rhit-olsonkc1/AdaCore-Protoboard/board/Board-Schematic.pdf

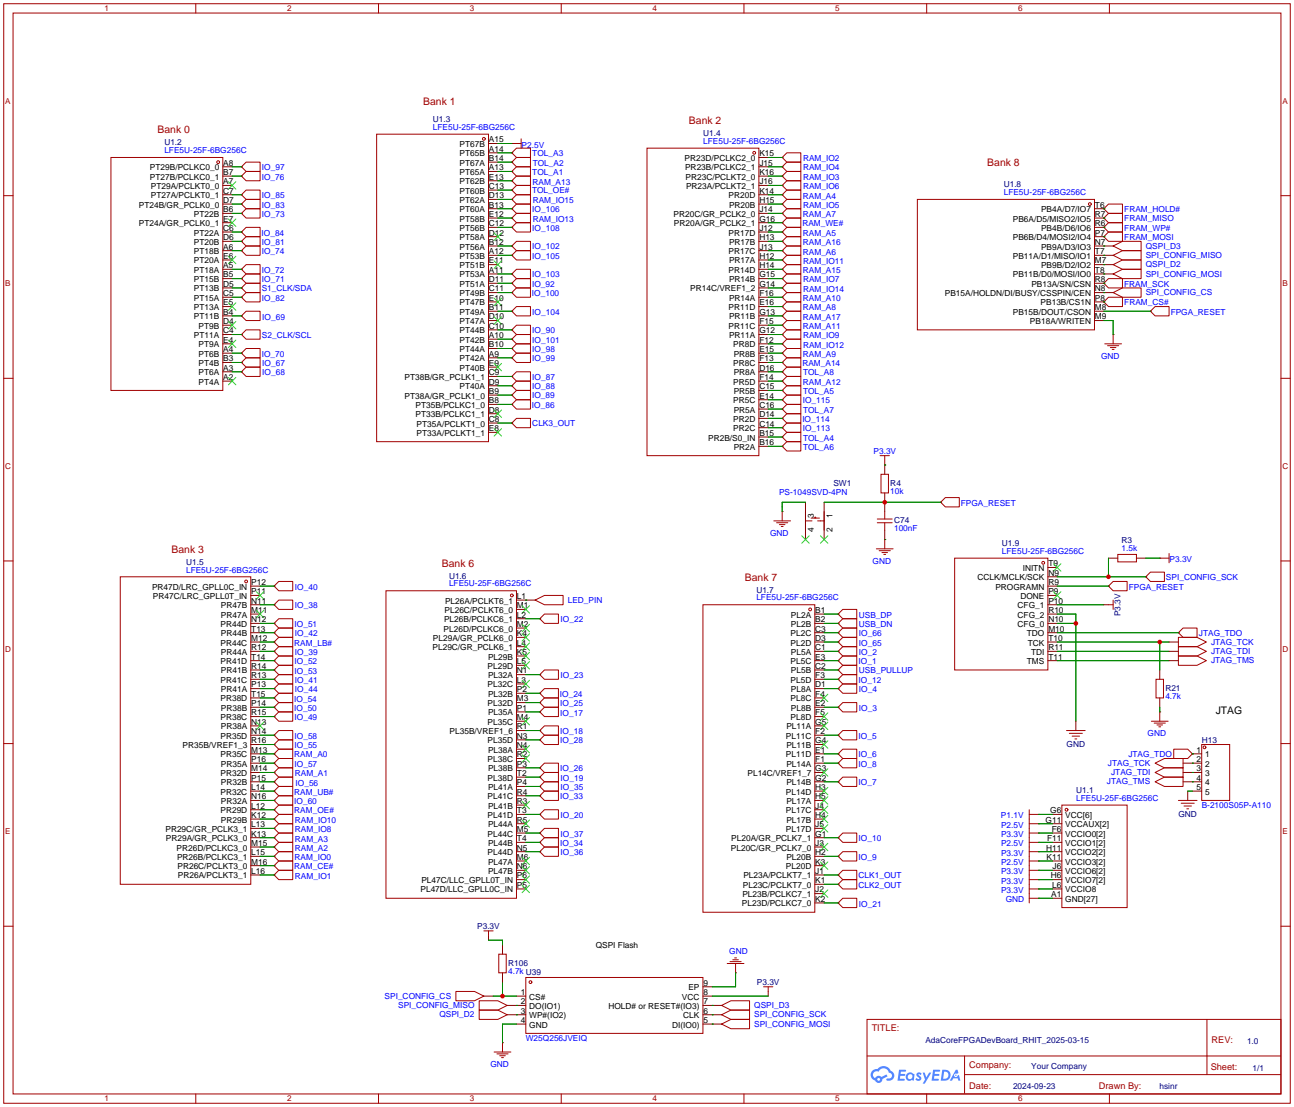
[picture p9: page 1]

PB15A/HOLDN/DI/BUSY/CSSPIN/CEN N8

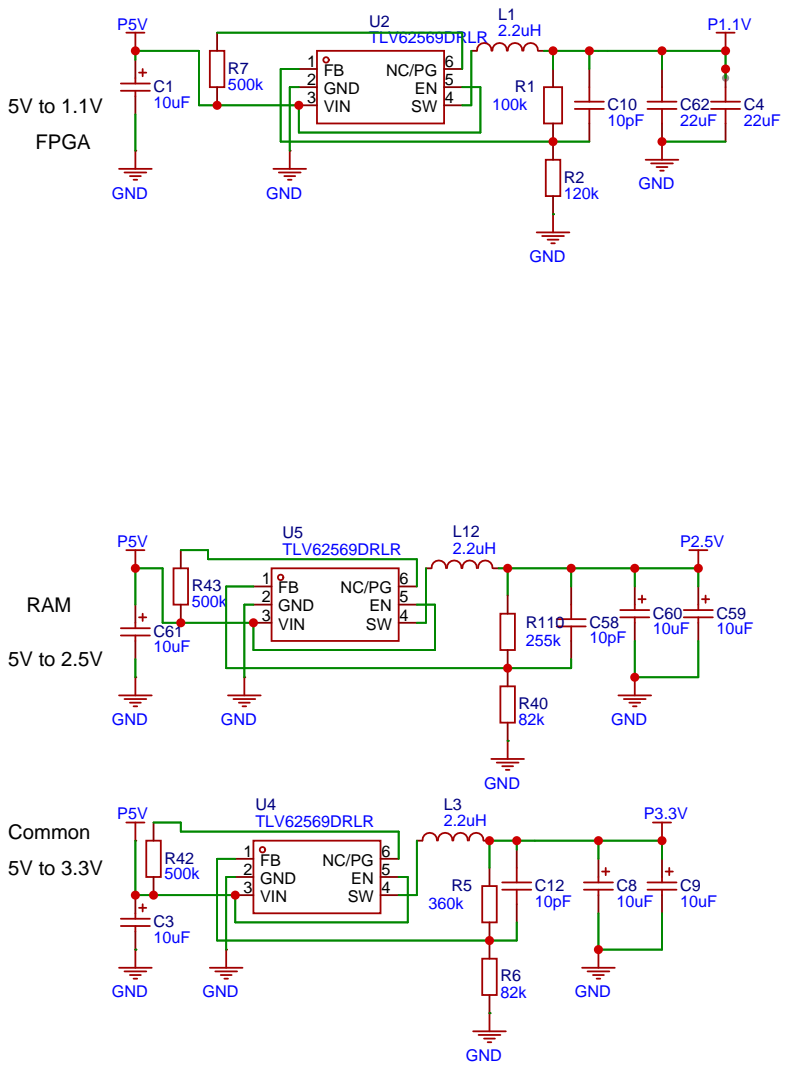
[picture p10: page 2]

Rose Hulman Institute of Technology

VDD D6 VDD E1 NC H6 NC H1 NC G2 NC E3 NC A6 GND D1 GND E6 I/O15 G1 I/O14 F1 I/O13 F2 I/O12 E2 I/O11 D2 I/O10 C2 I/O9 C1 I/O8 B1 I/O7 G6 I/O6 F6 I/O5 F5 I/O4 E5 I/O3 D5 I/O2 C6 I/O1 C5 I/O0 B6

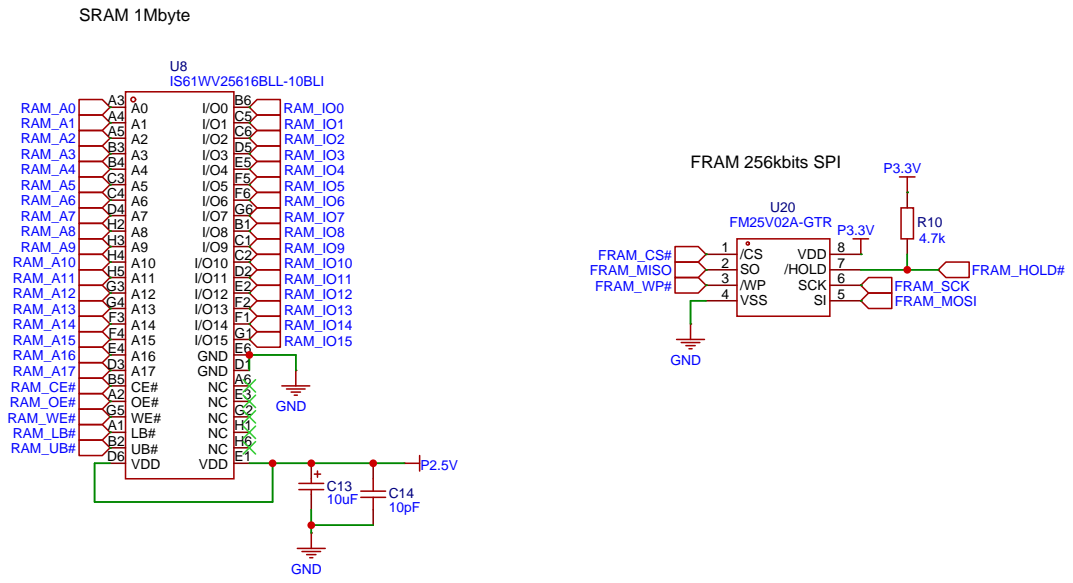
[picture p11: page 3]

ACBUS1 25 ACBUS2 26 ACBUS3 27 ACBUS4 28 ACBUS5 29 ACBUS6 30 ACBUS7 31 ACBUS8 32 ACBUS9 33 #RESET 34 GND 35 GND 36 VCCA ³⁷ VCCCORE ³⁸ VCCD ³⁹

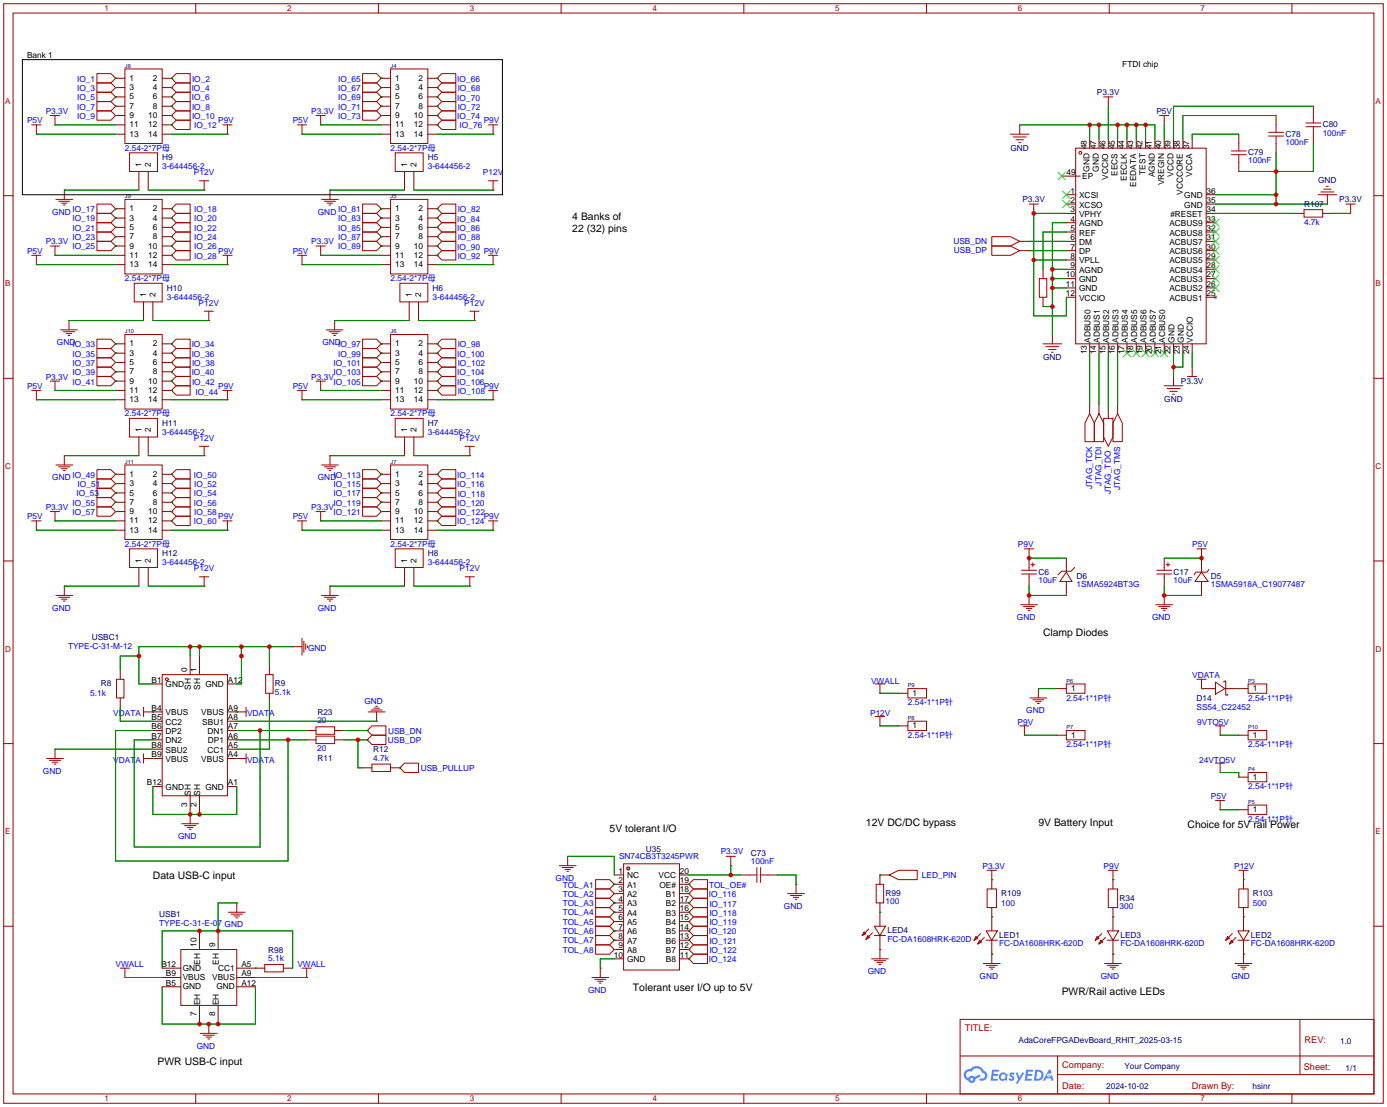
[picture p12: page 4]

Choice for 5V rail Power

GND
PWR/Rail active LEDs

Tolerant user I/O up to 5V

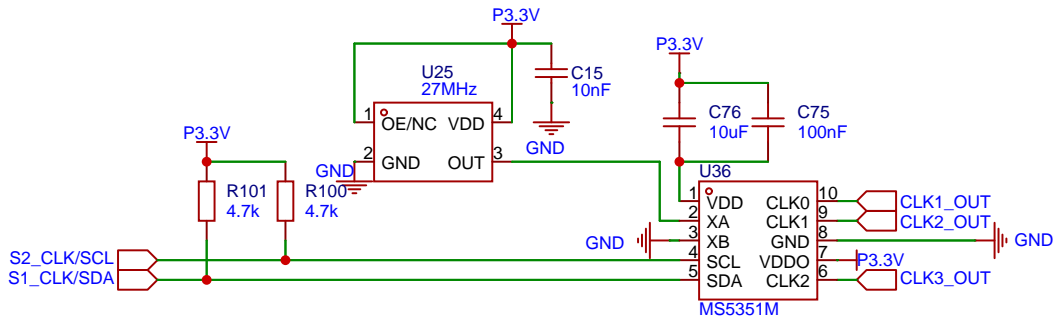
[picture p13: page 5]

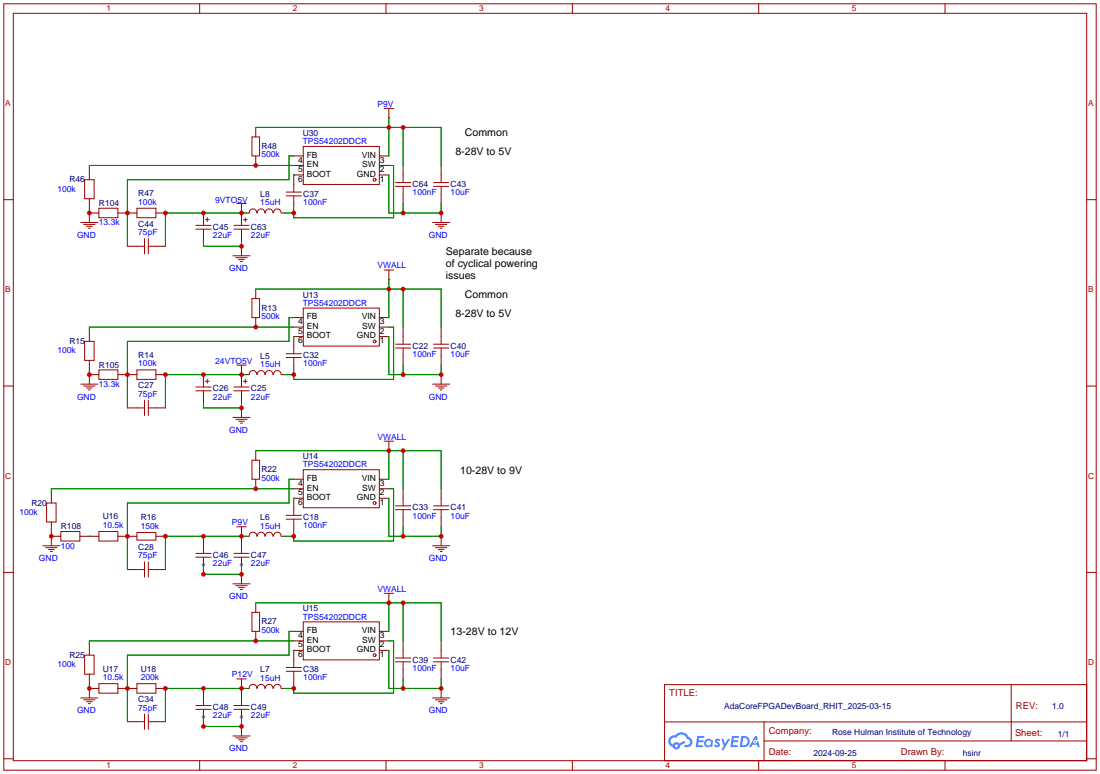
[picture p14: page 6]

Rose Hulman Institute of Technology
