rhit-olsonkc1/AdaCore-Protoboard/board/PCB_Print.pdf

# DATA

# USBC1 U1

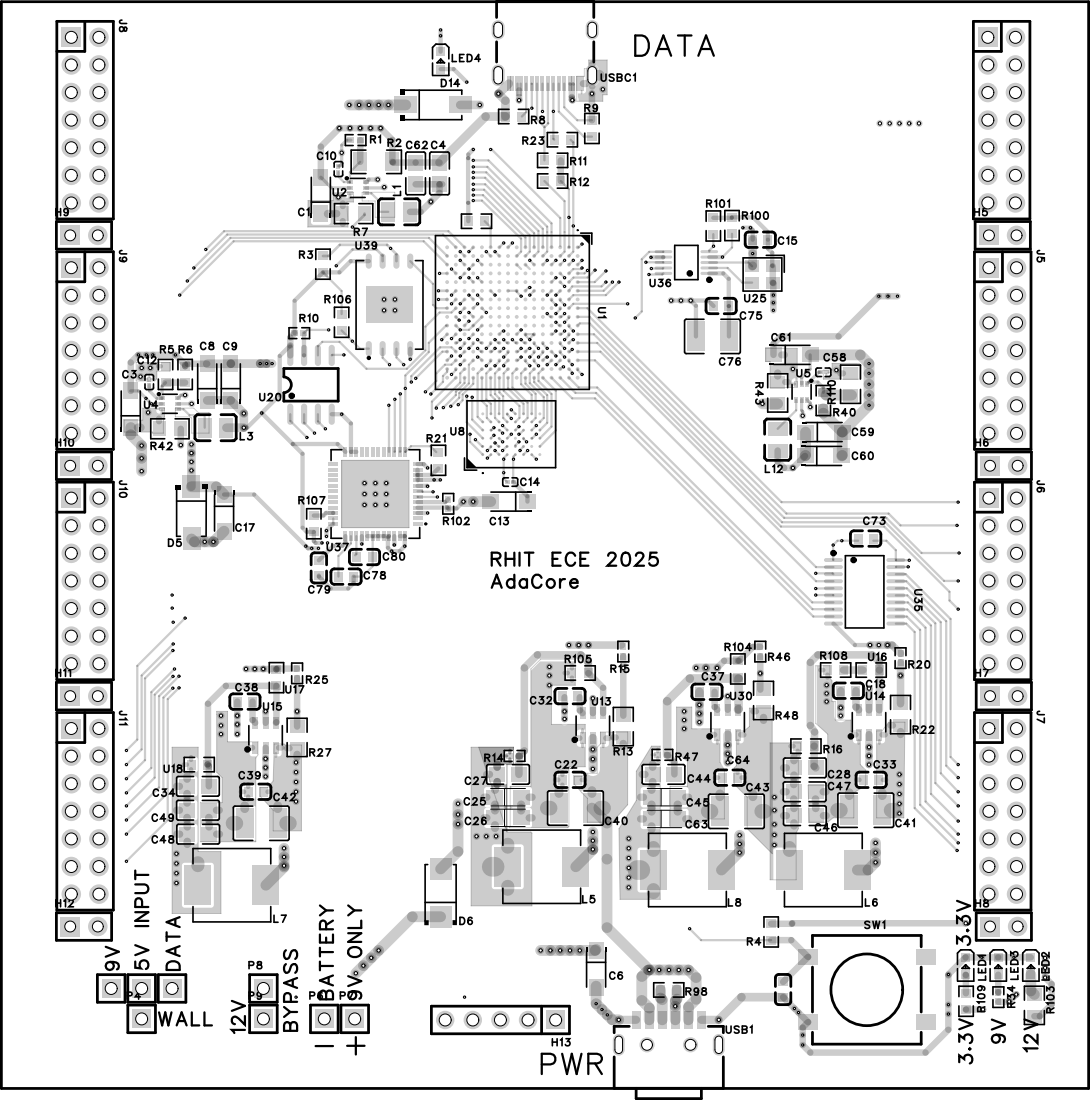
[picture p15: page 1]

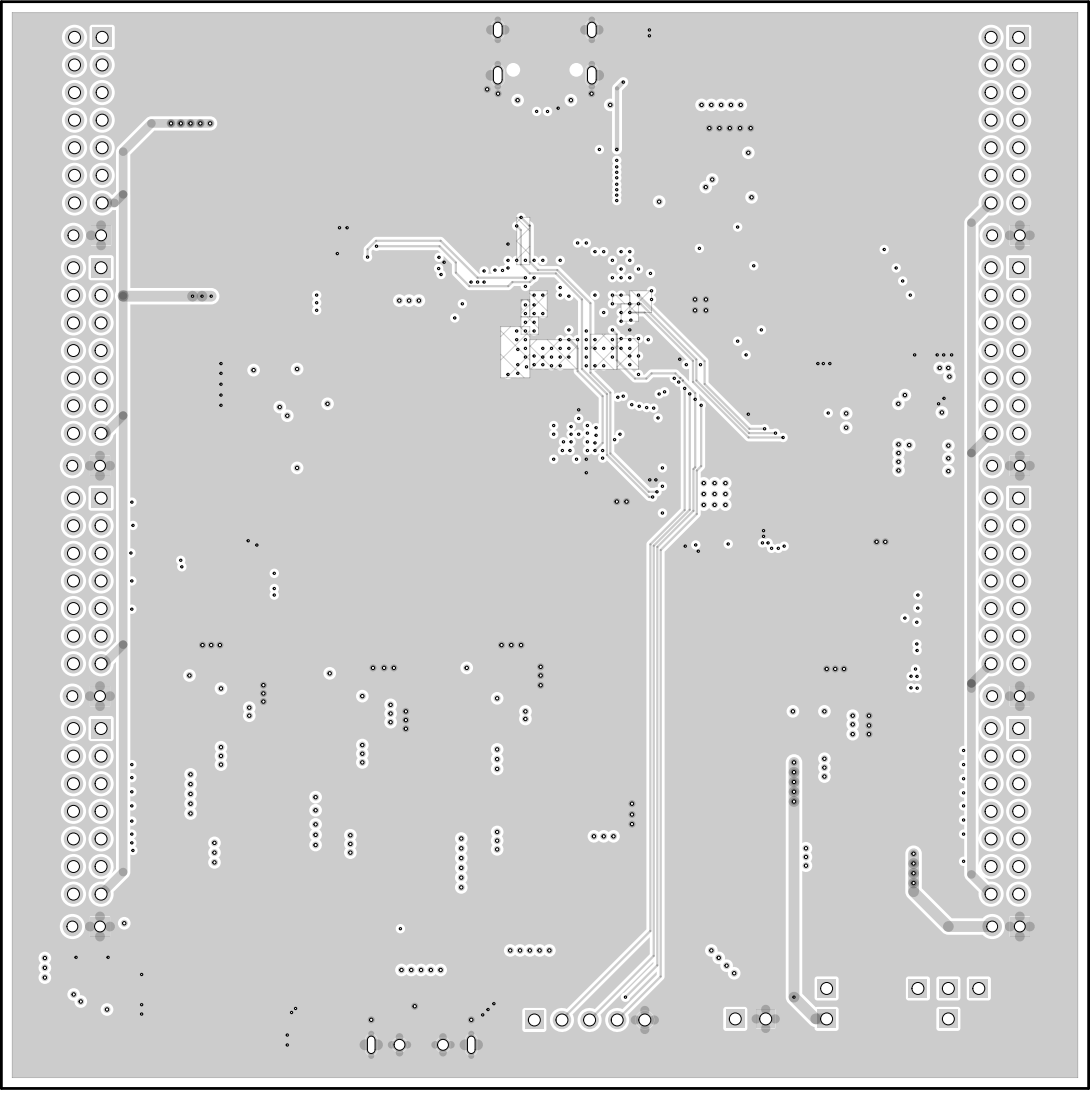
[picture p16: page 2]

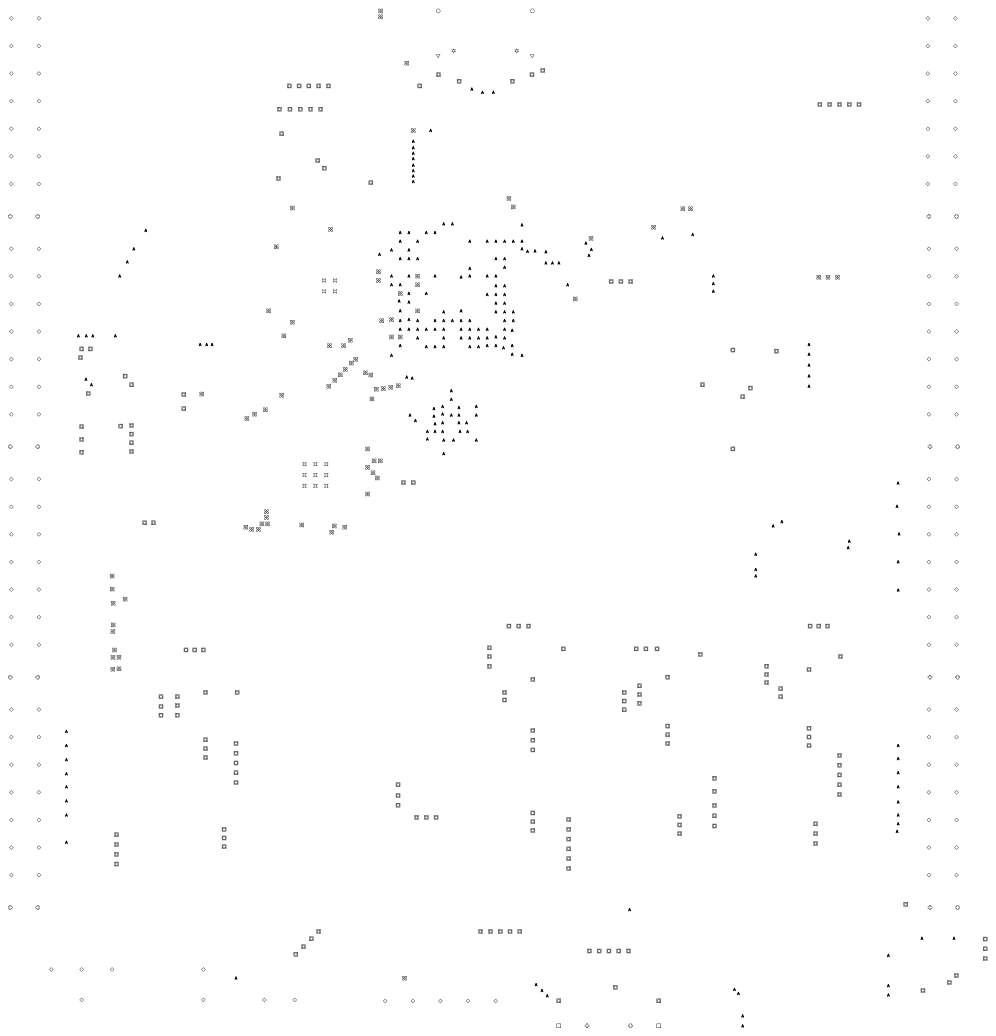
[picture p17: page 3]
