rhit-olsonkc1/AdaCore-Protoboard/board/peripheral-board/Default_Extension_Board_Schematic.pdf

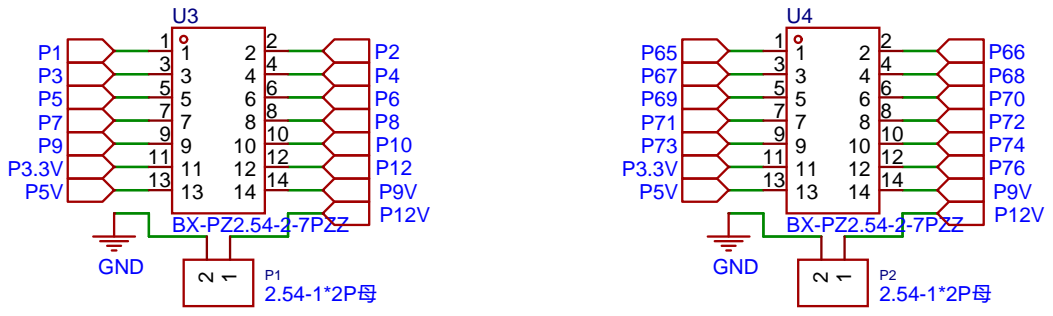
[picture p18: page 1]
