rhit-olsonkc1/AdaCore-Protoboard/board/peripheral-board/LCD_Extension_Board_Schematic.pdf

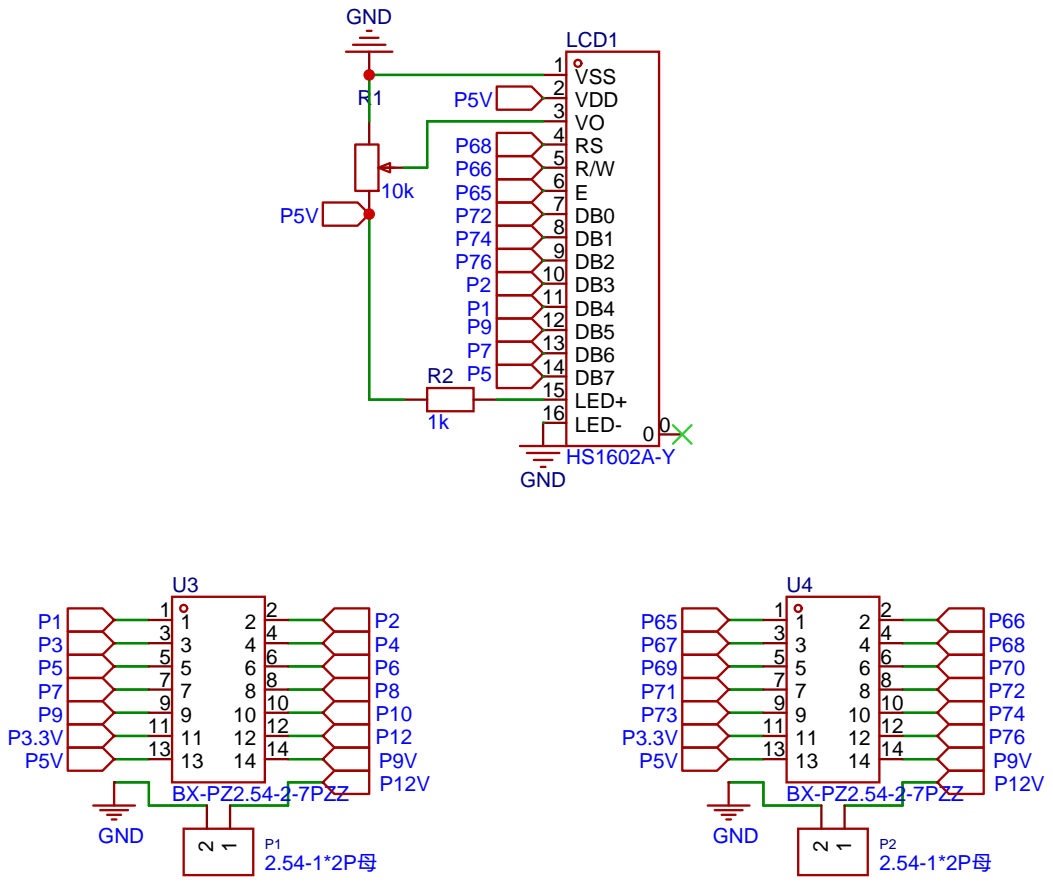
[picture p19: page 1]
