rhit-olsonkc1/AdaCore-Protoboard/board/peripheral-board/Default_Extension_Board_PCB.pdf

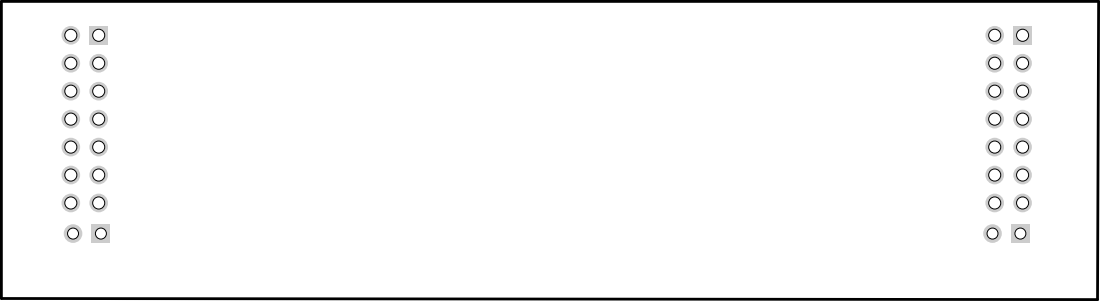
[picture p20: page 1]

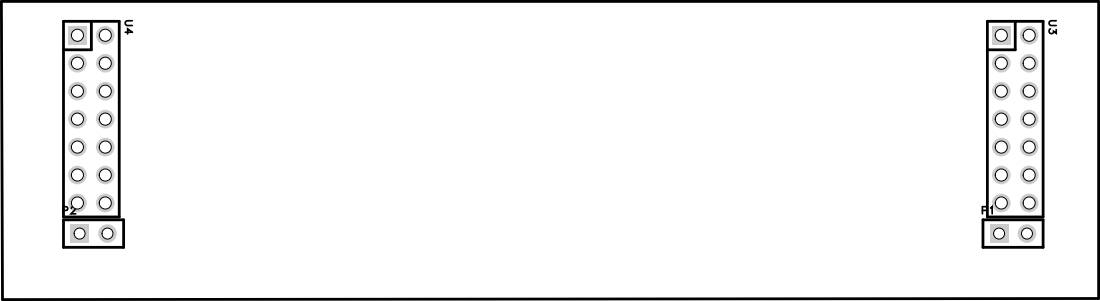
[picture p21: page 2]

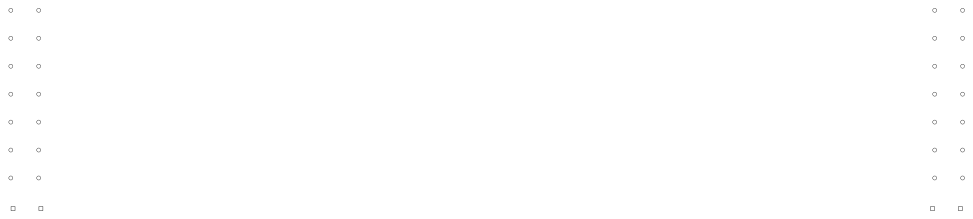
[picture p22: page 3]
