rhit-olsonkc1/AdaCore-Protoboard/board/peripheral-board/LCD_Extension_Board_PCB.pdf

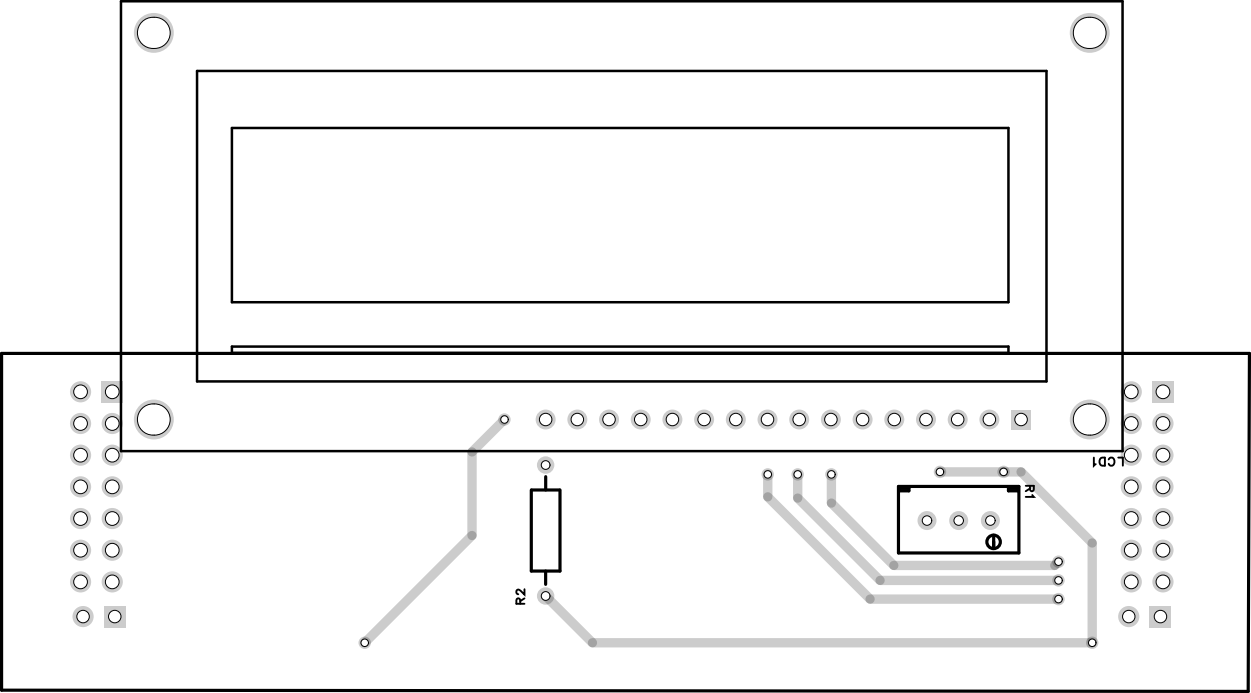
[picture p23: page 1]

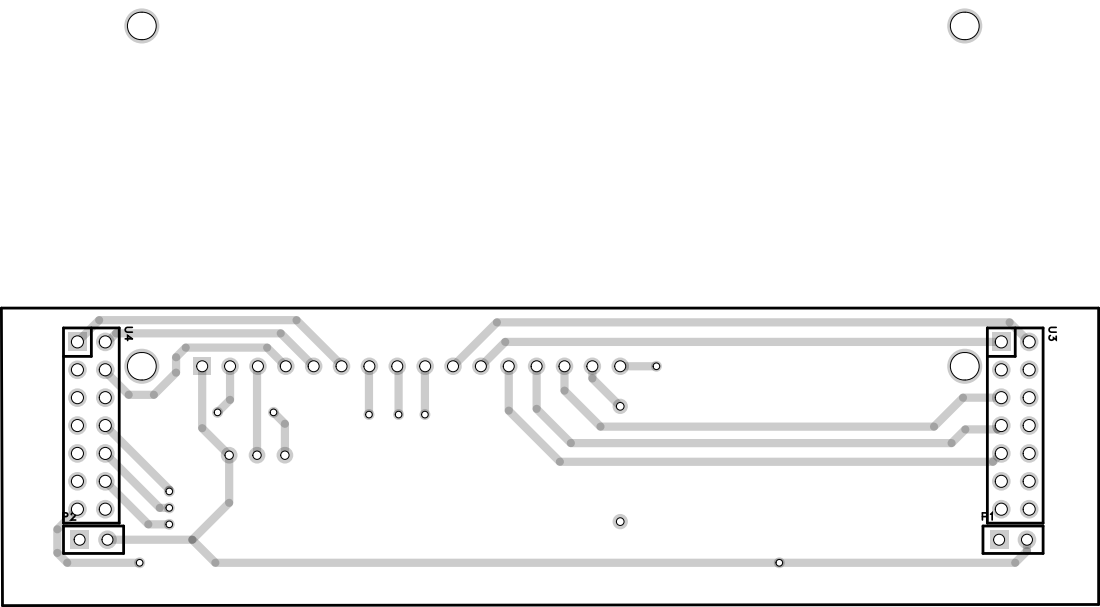
[picture p24: page 2]

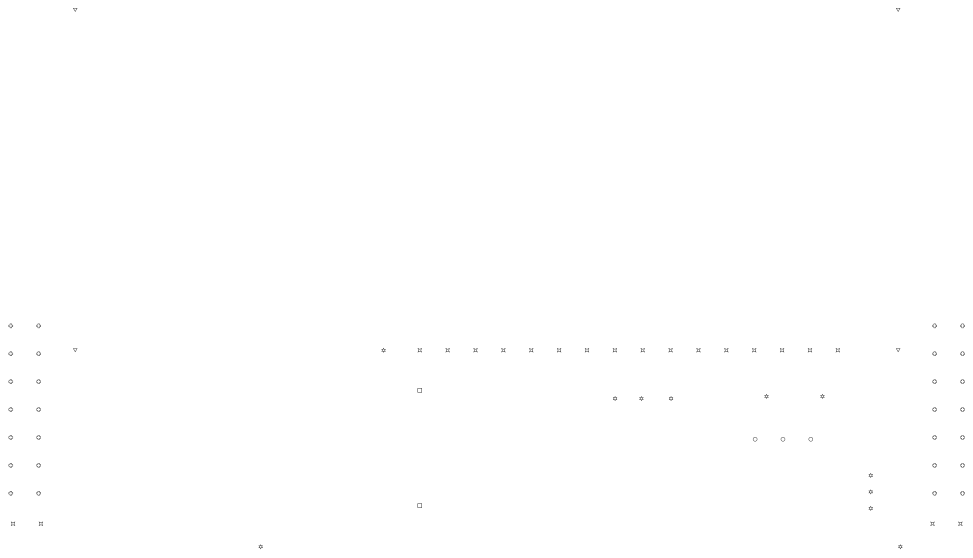
[picture p25: page 3]
