rhit-olsonkc1/AdaCore-Protoboard/(commit log)

2025-03-24 extension board
2025-03-25 blink LED ex
